lprib/sbc3/docs/hardware/screen_1_dims.webp

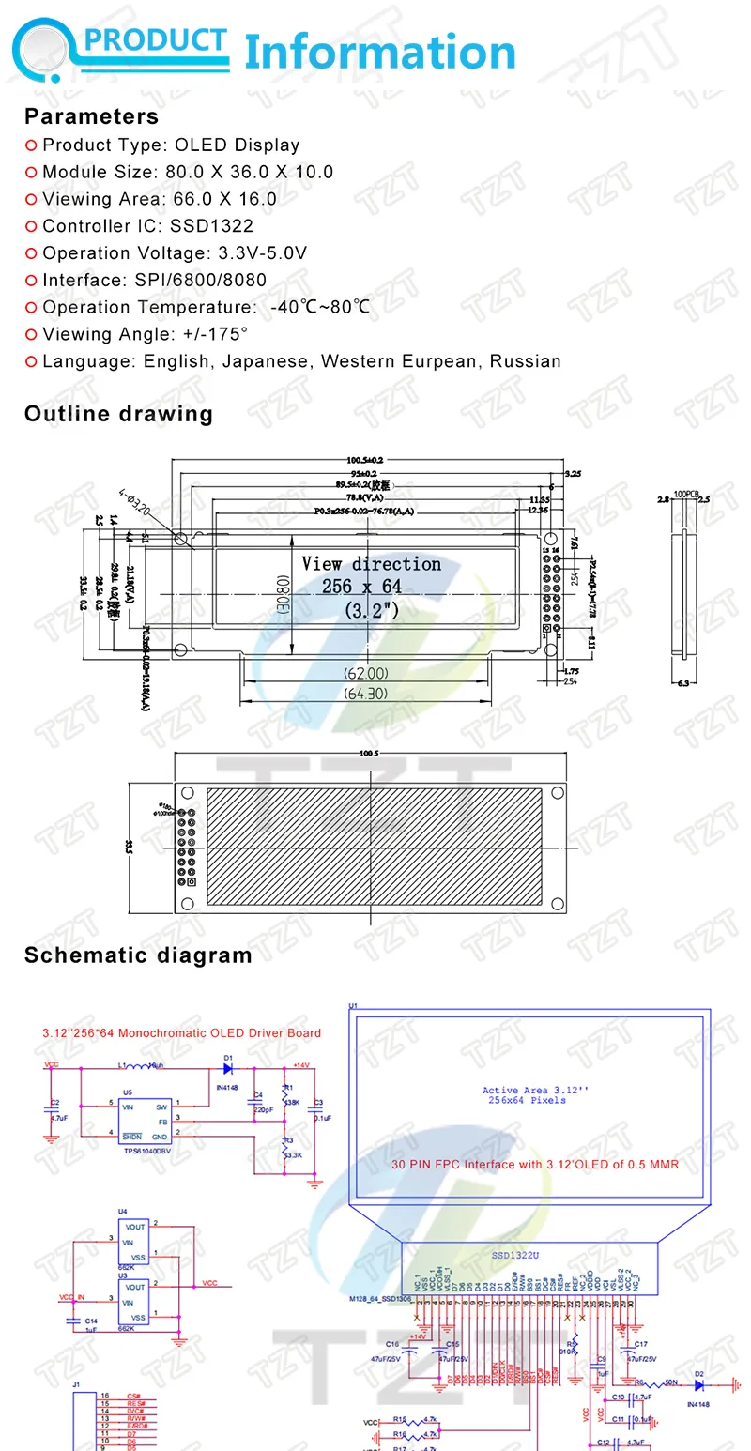
docs/hardware/screen_1_dims.webp
