lprib/sbc3/docs/hardware/ssd1322_oled_module.webp

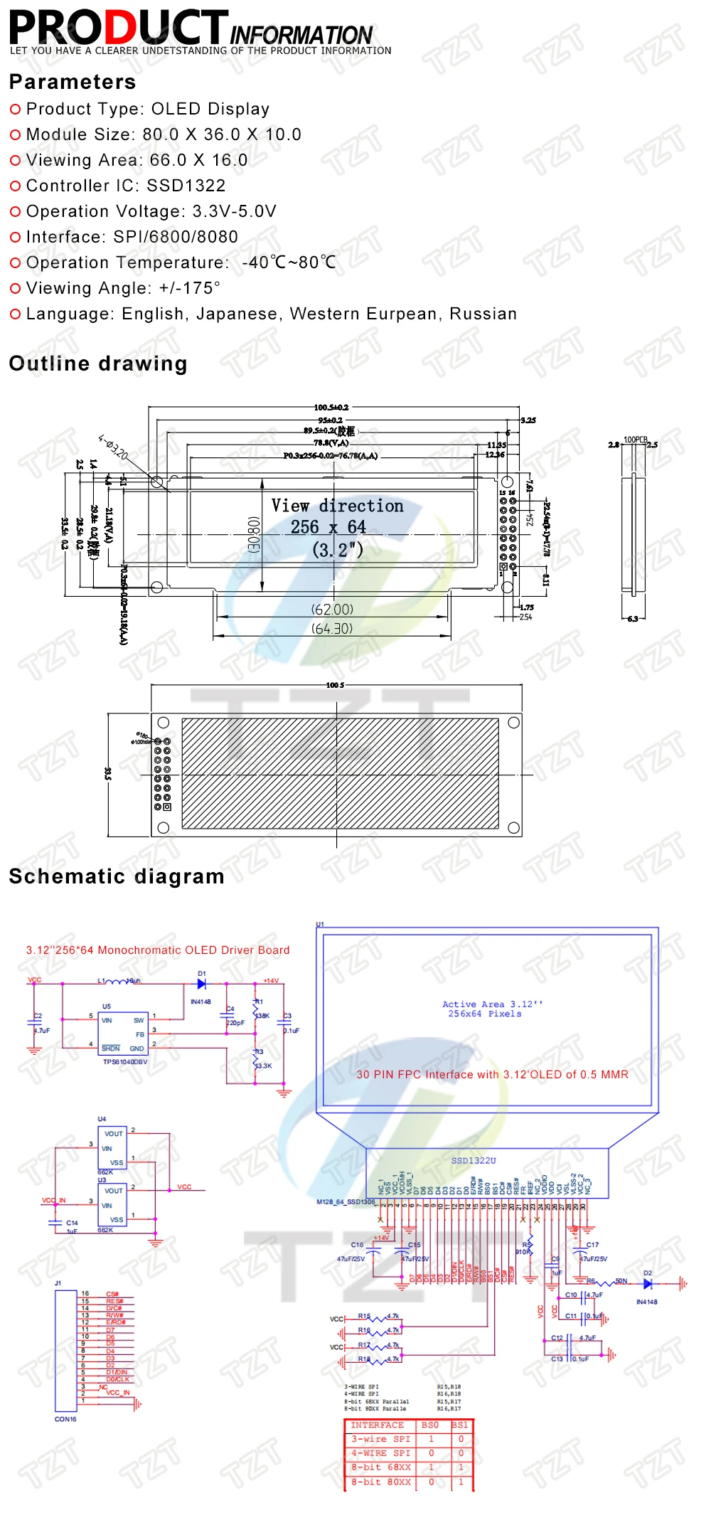
docs/hardware/ssd1322_oled_module.webp
