lprib/sbc3/rust_firmware/libui/src/text/font.png

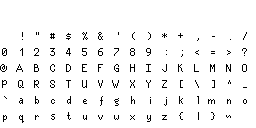
rust_firmware/libui/src/text/font.png
