lprib/sbc3/software/vm/pc_port/font2.png

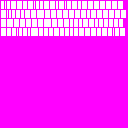
software/vm/pc_port/font2.png
