lprib/sbc3/keyboard_v1/keyboard.kicad_pcb

## KiCad design keyboard_v1/keyboard.kicad_pcb (2023-11-20)

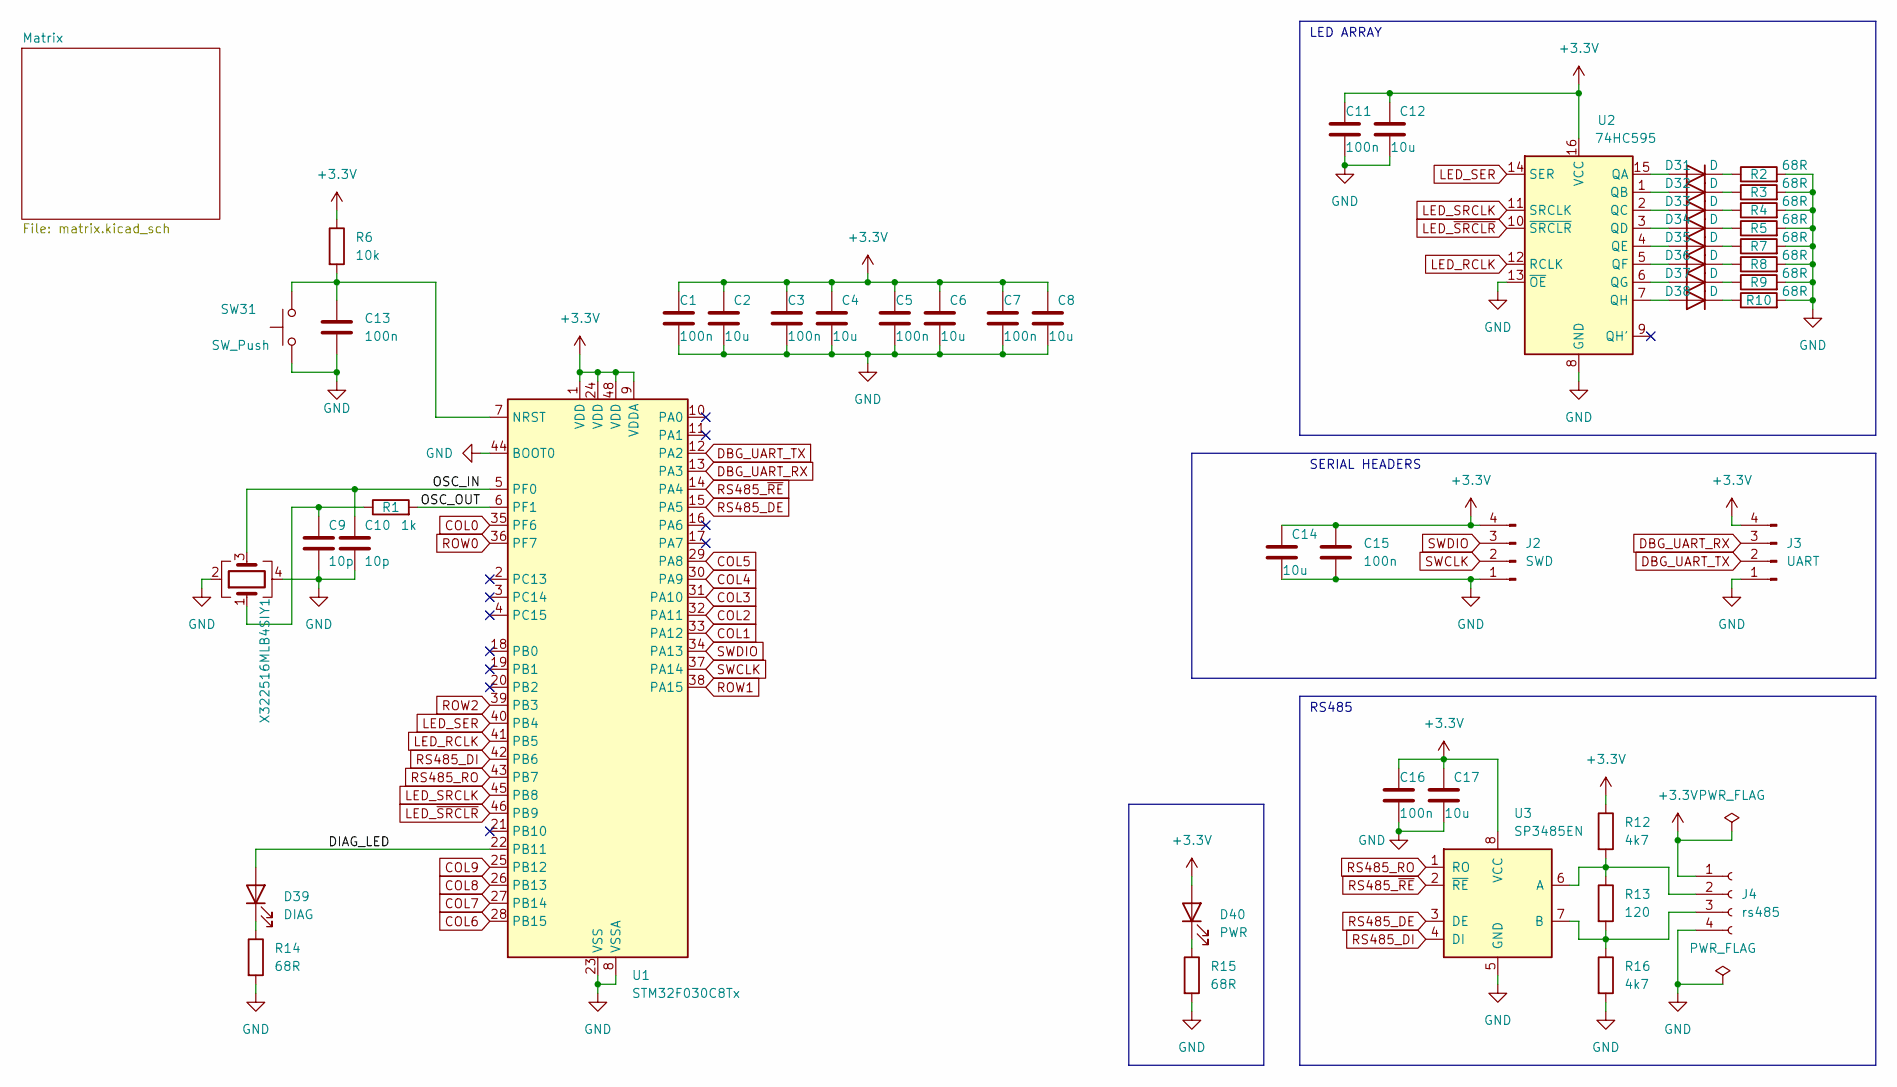
[picture p15: schematic keyboard.kicad_sch]

Parts:
C1, C3, C5, C7, C11, C13, C15, C16: 100n; C_0402_1005Metric; LCSC C307331
C2, C4, C6, C8, C12, C14, C17: 10u; C_0603_1608Metric; LCSC C96446
C9, C10: 10p; C_0402_1005Metric; LCSC C32949
D31, D32, D33, D34, D35, D36, D37, D38: D; D_0603_1608Metric; LCSC C72038
D39: DIAG; D_0603_1608Metric; LCSC C72038
D40: PWR; D_0603_1608Metric; LCSC C72038
J2: SWD; PinHeader_1x04_P2.54mm_Vertical
J3: UART; PinHeader_1x04_P2.54mm_Vertical
J4: rs485; JST_SH_SM04B-SRSS-TB_1x04-1MP_P1.00mm_Horizontal
R1: 1k; R_0402_1005Metric; LCSC C11702
R2, R3, R4, R5, R7, R8, R9, R10, R14, R15: 68R; R_0603_1608Metric; LCSC C27592
R6: 10k; R_0402_1005Metric; LCSC C25744
R12, R16: 4k7; R_1206_3216Metric; LCSC C17936
R13: 120; R_1206_3216Metric; LCSC C17909
SW31: SW_Push; SW_Push_1P1T_XKB_TS-1187A; LCSC C318884
U1: STM32F030C8Tx; LQFP-48_7x7mm_P0.5mm; LCSC C23922
U2: 74HC595; SOIC-16_3.9x9.9mm_P1.27mm; LCSC C5947
U3: SP3485EN; SOIC-8_3.9x4.9mm_P1.27mm
Y1: X322516MLB4SI; Crystal_SMD_SeikoEpson_TSX3225-4Pin_3.2x2.5mm; LCSC C13738

Connections:
+3.3V: C1.1, C2.1, C3.1, C4.1, C5.1, C6.1, C7.1, C8.1, C11.1, C12.1, C14.1, C15.1, C16.1, C17.1, D40.2 (A), J2.4, J3.4, J4.1, R6.1, R12.1, U1.1 (VDD), U1.9 (VDDA), U1.24 (VDD), U1.48 (VDD), U2.16 (VCC), U3.8 (VCC)
/DIAG_LED: D39.2 (A), U1.22 (PB11)
/OSC_IN: C10.1, U1.5 (PF0), Y1.3
/OSC_OUT: R1.2, U1.6 (PF1)
COL0: U1.35 (PF6); also elsewhere on the board
COL1: U1.33 (PA12); also elsewhere on the board
COL2: U1.32 (PA11); also elsewhere on the board
COL3: U1.31 (PA10); also elsewhere on the board
COL4: U1.30 (PA9); also elsewhere on the board
COL5: U1.29 (PA8); also elsewhere on the board
COL6: U1.28 (PB15); also elsewhere on the board
COL7: U1.27 (PB14); also elsewhere on the board
COL8: U1.26 (PB13); also elsewhere on the board
COL9: U1.25 (PB12); also elsewhere on the board
DBG_UART_RX: J3.3, U1.13 (PA3)
DBG_UART_TX: J3.2, U1.12 (PA2)
GND: C1.2, C2.2, C3.2, C4.2, C5.2, C6.2, C7.2, C8.2, C9.2, C10.2, C11.2, C12.2, C13.2, C14.2, C15.2, C16.2, C17.2, J2.1, J3.1, J4.4, R2.2, R3.2, R4.2, R5.2, R7.2, R8.2, R9.2, R10.2, R14.2, R15.2, R16.2, SW31.1, U1.8 (VSSA), U1.23 (VSS), U1.44 (BOOT0), U1.47 (VSS), U2.8 (GND), U2.13 (~OE), U3.5 (GND), Y1.2, Y1.4
LED_RCLK: U1.41 (PB5), U2.12 (RCLK)
LED_SER: U1.40 (PB4), U2.14 (SER)
LED_SRCLK: U1.45 (PB8), U2.11 (SRCLK)
LED_~SRCLR: U1.46 (PB9), U2.10 (~SRCLR)
unnamed: C9.1, R1.1, Y1.1
unnamed: D31.2 (A), U2.15 (QA)
unnamed: D31.1 (K), R2.1
unnamed: D32.2 (A), U2.1 (QB)
unnamed: D32.1 (K), R3.1
unnamed: D33.2 (A), U2.2 (QC)
unnamed: D33.1 (K), R4.1
unnamed: D34.2 (A), U2.3 (QD)
unnamed: D34.1 (K), R5.1
unnamed: D35.2 (A), U2.4 (QE)
unnamed: D35.1 (K), R7.1
unnamed: D36.2 (A), U2.5 (QF)
unnamed: D36.1 (K), R8.1
unnamed: D37.2 (A), U2.6 (QG)
unnamed: D37.1 (K), R9.1
unnamed: D38.2 (A), U2.7 (QH)
unnamed: D38.1 (K), R10.1
unnamed: D39.1 (K), R14.1
unnamed: D40.1 (K), R15.1
unnamed: J4.2, R12.2, R13.1, U3.6 (A)
unnamed: J4.3, R13.2, R16.1, U3.7 (B)
unnamed: C13.1, R6.2, SW31.2, U1.7 (NRST)
ROW0: U1.36 (PF7); also elsewhere on the board
ROW1: U1.38 (PA15); also elsewhere on the board
ROW2: U1.39 (PB3); also elsewhere on the board
RS485_DE: U1.15 (PA5), U3.3 (DE)
RS485_DI: U1.42 (PB6), U3.4 (DI)
RS485_RO: U1.43 (PB7), U3.1 (RO)
RS485_~RE: U1.14 (PA4), U3.2 (~RE)
SWCLK: J2.2, U1.37 (PA14)
SWDIO: J2.3, U1.34 (PA13)

Notes on the sheet:
RS485
SERIAL HEADERS
LED ARRAY

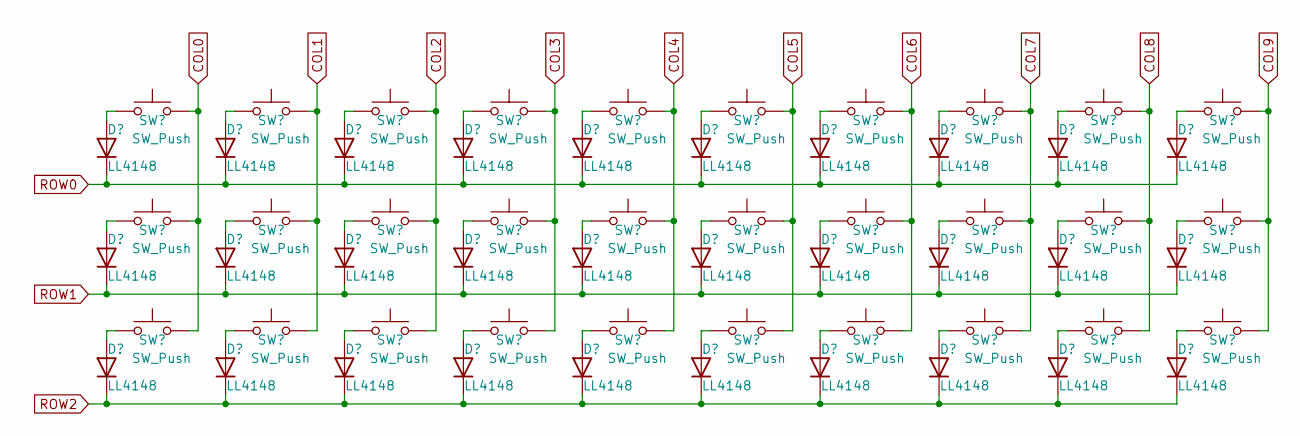
[picture p16: schematic matrix.kicad_sch]

Parts:
D1, D2, D3, D4, D5, D6, D7, D8, D9, D10, D11, D12, D13, D14, D15, D16, D17, D18, D19, D20, D21, D22, D23, D24, D25, D26, D27, D28, D29, D30: LL4148; D_1206_3216Metric; LCSC C9808
SW1, SW2, SW3, SW4, SW5, SW6, SW7, SW8, SW9, SW10, SW11, SW12, SW13, SW14, SW15, SW16, SW17, SW18, SW19, SW20, SW21, SW22, SW23, SW24, SW25, SW26, SW27, SW28, SW29, SW30: SW_Push; SW_Cherry_MX_1.00u_PCB

Connections:
COL0: SW1.2, SW11.2, SW21.2; also elsewhere on the board
COL1: SW2.2, SW12.2, SW22.2; also elsewhere on the board
COL2: SW3.2, SW13.2, SW23.2; also elsewhere on the board
COL3: SW4.2, SW14.2, SW24.2; also elsewhere on the board
COL4: SW5.2, SW15.2, SW25.2; also elsewhere on the board
COL5: SW6.2, SW16.2, SW26.2; also elsewhere on the board
COL6: SW7.2, SW17.2, SW27.2; also elsewhere on the board
COL7: SW8.2, SW18.2, SW28.2; also elsewhere on the board
COL8: SW9.2, SW19.2, SW29.2; also elsewhere on the board
COL9: SW10.2, SW20.2, SW30.2; also elsewhere on the board
unnamed: D1.2 (A), SW1.1
unnamed: D2.2 (A), SW2.1
unnamed: D3.2 (A), SW3.1
unnamed: D4.2 (A), SW4.1
unnamed: D5.2 (A), SW5.1
unnamed: D6.2 (A), SW6.1
unnamed: D7.2 (A), SW7.1
unnamed: D8.2 (A), SW8.1
unnamed: D9.2 (A), SW9.1
unnamed: D10.2 (A), SW10.1
unnamed: D11.2 (A), SW11.1
unnamed: D12.2 (A), SW12.1
unnamed: D13.2 (A), SW13.1
unnamed: D14.2 (A), SW14.1
unnamed: D15.2 (A), SW15.1
unnamed: D16.2 (A), SW16.1
unnamed: D17.2 (A), SW17.1
unnamed: D18.2 (A), SW18.1
unnamed: D19.2 (A), SW19.1
unnamed: D20.2 (A), SW20.1
unnamed: D21.2 (A), SW21.1
unnamed: D22.2 (A), SW22.1
unnamed: D23.2 (A), SW23.1
unnamed: D24.2 (A), SW24.1
unnamed: D25.2 (A), SW25.1
unnamed: D26.2 (A), SW26.1
unnamed: D27.2 (A), SW27.1
unnamed: D28.2 (A), SW28.1
unnamed: D29.2 (A), SW29.1
unnamed: D30.2 (A), SW30.1
ROW0: D1.1 (K), D2.1 (K), D3.1 (K), D4.1 (K), D5.1 (K), D6.1 (K), D7.1 (K), D8.1 (K), D9.1 (K), D10.1 (K); also elsewhere on the board
ROW1: D11.1 (K), D12.1 (K), D13.1 (K), D14.1 (K), D15.1 (K), D16.1 (K), D17.1 (K), D18.1 (K), D19.1 (K), D20.1 (K); also elsewhere on the board
ROW2: D21.1 (K), D22.1 (K), D23.1 (K), D24.1 (K), D25.1 (K), D26.1 (K), D27.1 (K), D28.1 (K), D29.1 (K), D30.1 (K); also elsewhere on the board

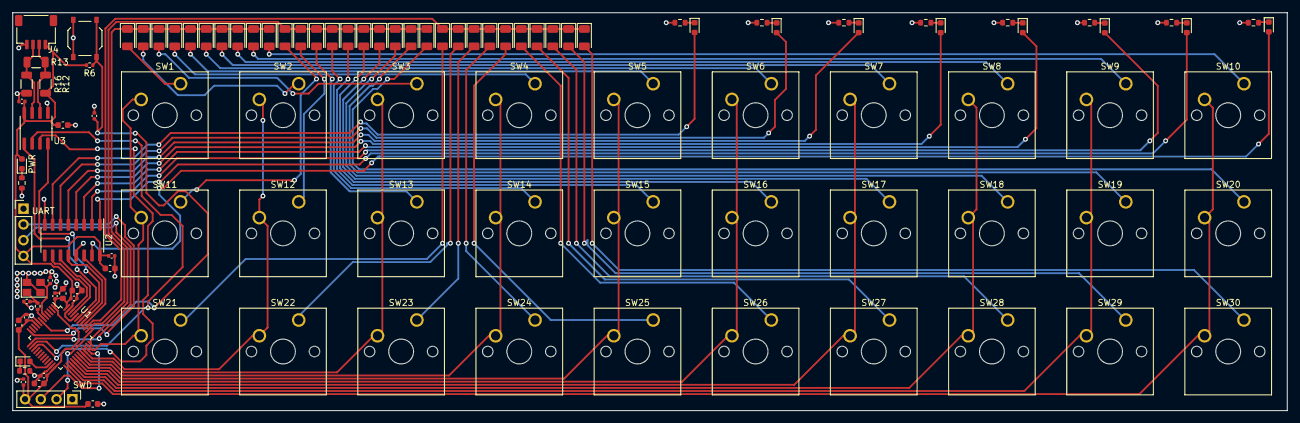
[picture p17: board keyboard.kicad_pcb from above]

Board: 2 copper layers, 205.5 x 64.2 mm, 110 parts (0 on the bottom side), 82 nets.
