lprib/sbc3/main_board_v1/sbc3_pcb.kicad_pcb

## KiCad design main_board_v1/sbc3_pcb.kicad_pcb (2023-11-12)

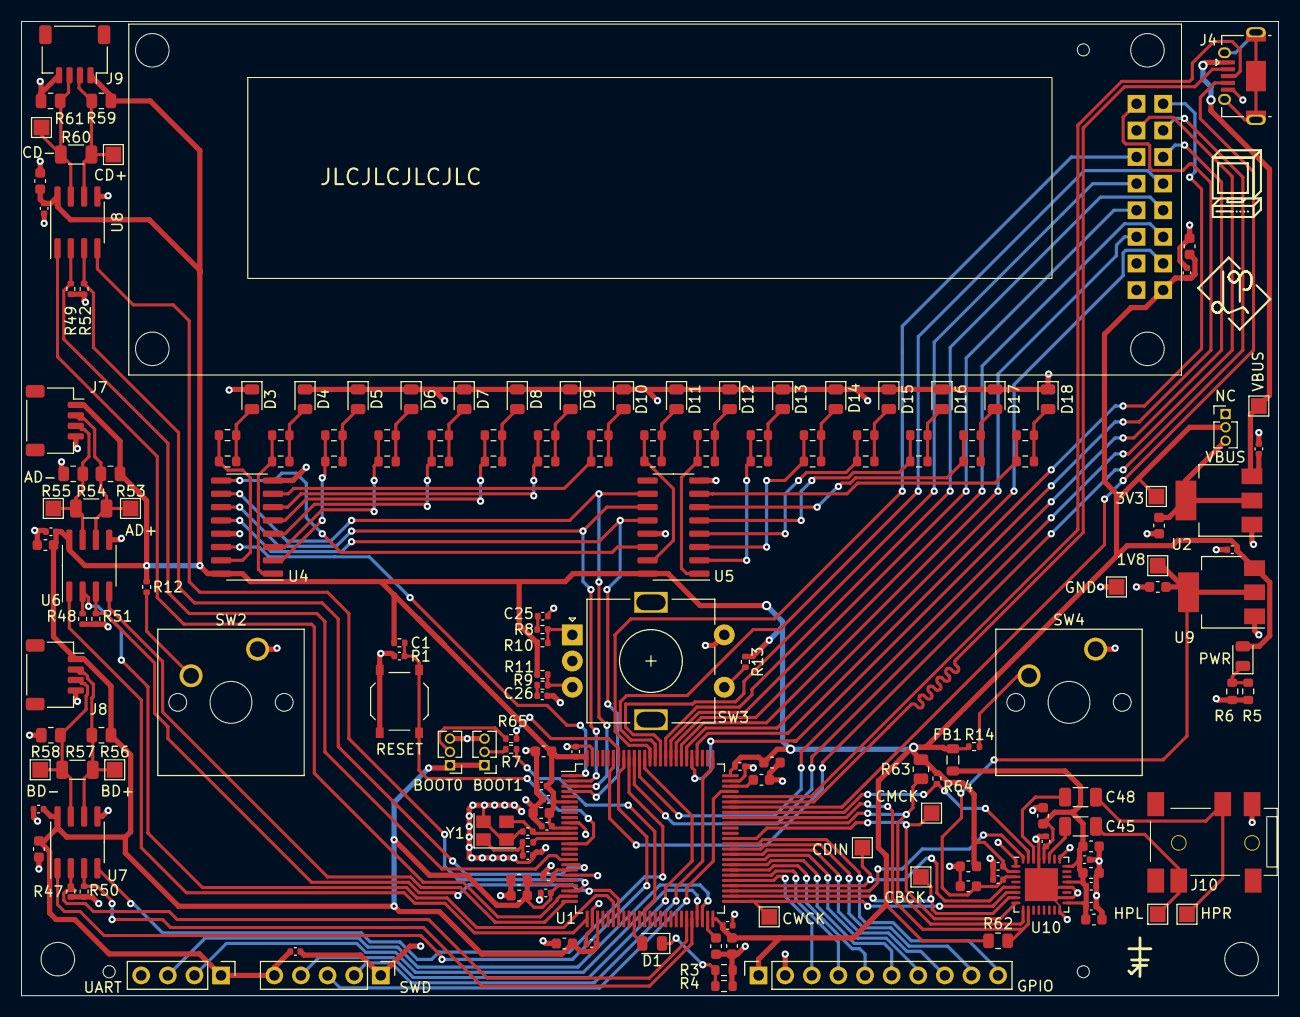
[picture p18: board sbc3_pcb.kicad_pcb from above]

Board: 2 copper layers, 120.0 x 93.0 mm, 181 parts (0 on the bottom side), 122 nets.

Parts:
C1, C6, C9, C11, C12, C14, C17, C18, C20, C22, C24, C28, C29, C31, C33, C35, C40, C42, C44, C47, C50, C52: 100n; C_0402_1005Metric
C2, C3: 10p; C_0402_1005Metric
C4, C5: 2.2u; C_0603_1608Metric
C7: 1u; C_0402_1005Metric
C8, C10, C13, C15, C16, C19, C21, C23, C27, C30, C32, C34, C36, C39, C41, C43, C46, C49, C51: 10u; C_0603_1608Metric
C25, C26: 10n; C_0402_1005Metric
C45, C48: 47u; C_1206_3216Metric
D1: DBG; LED_0805_2012Metric
D2: PWR; LED_0805_2012Metric
D3, D4, D5, D6, D7, D8, D9, D10, D11, D12, D13, D14, D15, D16, D17, D18: LED; LED_0805_2012Metric
FB1: FerriteBead; L_0805_2012Metric
H1, H2: MountingHole; MountingHole_3.2mm_M3
H3, H4, H5: MountingHole; MountingHole_JLCPCB_Assembly
J1: VBUS CON; PinHeader_1x03_P1.27mm_Vertical
J2: BOOT0; PinHeader_1x03_P1.27mm_Vertical
J3: GPIO; PinSocket_1x10_P2.54mm_Vertical
J4: USB_B_Micro; USB_Micro-AB_Molex_47590-0001
J5: UART; PinHeader_1x04_P2.54mm_Vertical
J6: SWD; PinHeader_1x05_P2.54mm_Vertical
J7, J8, J9: Conn_01x04_Socket; JST_SH_SM04B-SRSS-TB_1x04-1MP_P1.00mm_Horizontal
J10: PJ-342
J11: BOOT1; PinHeader_1x03_P1.27mm_Vertical
R1, R7, R8, R9, R10, R11, R12, R13, R14, R47, R48, R49, R50, R51, R52, R64, R65: 10k; R_0402_1005Metric
R2: 1k; R_0402_1005Metric
R3, R4, R5, R6, R15, R16, R17, R18, R19, R20, R21, R22, R23, R24, R25, R26, R27, R28, R29, R30, R31, R32, R33, R34, R35, R36, R37, R38, R39, R40, R41, R42, R43, R44, R45, R46: 150; R_0603_1608Metric
R53, R55, R56, R58, R59, R61, R62, R63: 4k7; R_0805_2012Metric
R54, R57, R60: 120; R_1206_3216Metric
SW1: RESET; SW_Push_1P1T_XKB_TS-1187A
SW2, SW4: CHERRY_SWITCH; SW_Cherry_MX_1.00u_PCB
SW3: RotaryEncoder_Switch; RotaryEncoder_Alps_EC11E-Switch_Vertical_H20mm
TP1: 3V3; MyTP
TP3: VBUS; MyTP
TP4: AD+; MyTP
TP5: AD-; MyTP
TP6: BD+; MyTP
TP7: BD-; MyTP
TP8: CD+; MyTP
TP9: CD-; MyTP
TP10: 1V8; MyTP
TP11: CMCK; MyTP
TP12: CDIN; MyTP
TP13: CBCK; MyTP
TP14: CWCK; MyTP
TP15: HPR; MyTP
TP16: HPL; MyTP
TP17: GND; MyTP
U1: STM32F405VGT6; LQFP-100_14x14mm_P0.5mm
U2: LD1117S33TR_SOT223; SOT-223-3_TabPin2
U3: 256x64 SSD1322 Module; SSD1322_oled_module_3.12inch
U4, U5: 74HC595D,118; SOIC-16_3.9x9.9mm_P1.27mm
U6, U7, U8: SP3485EN-L/TR; SOIC-8_3.9x4.9mm_P1.27mm
U9: LD1117S18TR_SOT223; SOT-223-3_TabPin2
U10: TLV320DAC3101IRHBR; VQFN-32-1EP_5x5mm_P0.5mm_EP3.15x3.15mm
Y1: 16MHz; Crystal_SMD_3225-4Pin_3.2x2.5mm

Connections:
+1V8: C36.1, C51.1, C52.1, TP10.1, U9.2 (VO), U10.3 (DVDD)
+3.3V: C6.1, C7.1, C8.1, C9.1, C10.1, C12.1, C13.1, C14.1, C15.1, C17.1, C18.1, C19.1, C20.1, C21.1, C22.1, C23.1, C24.1, C27.1, C28.1, C29.1, C30.1, C31.1, C32.1, C33.1, C34.1, C35.1, C49.1, C50.1, D2.2 (A), FB1.1, J1.2, J2.1, J3.1, J5.1, J6.5, J7.1, J8.1, J9.1, J11.1, R1.2, R10.2, R11.2, R12.1, R13.1, R14.1, R53.1, R56.1, R59.1, R62.1, R63.1, R64.1, TP1.1, U1.6 (VBAT), U1.11 (VDD), U1.19 (VDD), U1.21 (VREF+), U1.22 (VDDA), U1.28 (VDD), U1.50 (VDD), U1.75 (VDD), U1.100 (VDD), U3.2 (VCC), U4.16 (VCC), U5.16 (VCC), U6.8 (VCC), U7.8 (VCC), U8.8 (VCC), U9.3 (VI), U10.2 (IOVDD)
/Audio/HPL_OUT: C45.1, J10.5 (T), TP16.1
/Audio/HPL_PRE: C45.2, U10.27 (HPL)
/Audio/HPR_OUT: C48.1, J10.4 (R2), TP15.1
/Audio/HPR_PRE: C48.2, U10.30 (HPR)
/Audio/HP_VDD: C39.1, C40.1, C41.1, C42.1, C43.1, C44.1, C46.1, C47.1, FB1.2, U10.17 (AVDD), U10.21 (SPLVDD), U10.24 (SPRVDD), U10.28 (HPVDD)
/BOOT0: R7.2, U1.94 (BOOT0)
/BOOT1: R65.2, U1.37 (PB2)
/CODEC_BCLK: TP13.1, U1.52 (PB13), U10.7 (BCLK)
/CODEC_DIN: TP12.1, U1.54 (PB15), U10.5 (DIN)
/CODEC_GPIO1: U1.53 (PB14), U10.32 (GPIO1)
/CODEC_MCLK: TP11.1, U1.63 (PC6), U10.8 (MCLK)
/CODEC_NRESET: R64.2, U1.68 (PA9), U10.31 (~RESET)
/CODEC_SCL: R62.2, U1.67 (PA8), U10.10 (SCL)
/CODEC_SDA: R63.2, U1.66 (PC9), U10.9 (SDA)
/CODEC_WCLK: TP14.1, U1.51 (PB12), U10.6 (WCLK)
/Comms/RS485_A_D+: J7.2, R53.2, R54.1, TP4.1, U6.6 (A)
/Comms/RS485_A_D-: J7.3, R54.2, R55.1, TP5.1, U6.7 (B)
/Comms/RS485_B_D+: J8.2, R56.2, R57.1, TP6.1, U7.6 (A)
/Comms/RS485_B_D-: J8.3, R57.2, R58.1, TP7.1, U7.7 (B)
/Comms/RS485_C_D+: J9.2, R59.2, R60.1, TP8.1, U8.6 (A)
/Comms/RS485_C_D-: J9.3, R60.2, R61.1, TP9.1, U8.7 (B)
/DBG_LED: D1.2 (A), U1.35 (PB0)
/DBG_UART_RX: J5.3, U1.48 (PB11)
/DBG_UART_TX: J5.2, U1.47 (PB10)
/EXT_A.DE: R51.1, U1.32 (PA7), U6.3 (DE)
/EXT_A.DI: U1.25 (PA2), U6.4 (DI)
/EXT_A.NRE: R48.1, U1.31 (PA6), U6.2 (~RE)
/EXT_A.RO: U1.26 (PA3), U6.1 (RO)
/EXT_B.DE: R50.1, U1.46 (PE15), U7.3 (DE)
/EXT_B.DI: U1.92 (PB6), U7.4 (DI)
/EXT_B.NRE: R47.1, U1.45 (PE14), U7.2 (~RE)
/EXT_B.RO: U1.93 (PB7), U7.1 (RO)
/EXT_C.DE: R52.1, U1.18 (PC3), U8.3 (DE)
/EXT_C.DI: U1.23 (PA0), U8.4 (DI)
/EXT_C.NRE: R49.1, U1.17 (PC2), U8.2 (~RE)
/EXT_C.RO: U1.24 (PA1), U8.1 (RO)
/GPIOA_0: J3.3, U1.55 (PD8)
/GPIOA_1: J3.4, U1.56 (PD9)
/GPIOA_2: J3.5, U1.57 (PD10)
/GPIOA_3: J3.6, U1.58 (PD11)
/GPIOA_4: J3.7, U1.59 (PD12)
/GPIOA_5: J3.8, U1.60 (PD13)
/GPIOA_6: J3.9, U1.61 (PD14)
/GPIOA_7: J3.10, U1.62 (PD15)
/LEDS.RCLK: U1.4 (PE5), U4.12 (RCLK), U5.12 (RCLK)
/LEDS.SER: U1.1 (PE2), U4.14 (SER)
/LEDS.SRCLK: U1.2 (PE3), U4.11 (SRCLK), U5.11 (SRCLK)
/LEDS.SRCLR: U1.3 (PE4), U4.10 (~SRCLR), U5.10 (~SRCLR)
/MMI_ROTARY_A: C26.1, R9.1
/MMI_ROTARY_B: C25.1, R8.1
/MMI_ROTARY_PUSH: R13.2, SW3.S1
/MMI_SW_A: R12.2, SW2.2
/MMI_SW_B: R14.2, SW4.2
/OSC_IN: C3.1, U1.12 (PH0), Y1.3
/OSC_OUT: R2.2, U1.13 (PH1)
/SCR.CS: U1.79 (PC11), U3.16 (~CS)
/SCR.D0: U1.81 (PD0), U3.4 (D0/SCLK)
/SCR.D1: U1.82 (PD1), U3.5 (D1/SDATA)
/SCR.D2: U1.83 (PD2), U3.6 (D2)
/SCR.D3: U1.84 (PD3), U3.7 (D3)
/SCR.D4: U1.85 (PD4), U3.8 (D4)
/SCR.D5: U1.86 (PD5), U3.9 (D5)
/SCR.D6: U1.87 (PD6), U3.10 (D6)
/SCR.D7: U1.88 (PD7), U3.11 (D7)
/SCR.DC: U1.95 (PB8), U3.14 (D~C)
/SCR.E: U1.90 (PB4), U3.12 (E/~RD)
/SCR.RST: U1.80 (PC12), U3.15 (~RST)
/SCR.RW: U1.91 (PB5), U3.13 (R~W)
/SWD_CLK: J6.2, U1.76 (PA14)
/SWD_IO: J6.3, U1.72 (PA13)
/SWD_O: J6.4, U1.89 (PB3)
/USB_D+: J4.3 (D+), U1.71 (PA12)
/USB_D-: J4.2 (D-), U1.70 (PA11)
/USB_ID: J4.4 (ID), U1.69 (PA10)
/USB_VBUS: C11.1, J4.1 (VBUS), TP3.1, U2.3 (VI)
GND: C1.2, C2.2, C3.2, C4.2, C5.2, C6.2, C7.2, C8.2, C9.2, C10.2, C11.2, C12.2, C13.2, C14.2, C15.2, C16.2, C17.2, C18.2, C19.2, C20.2, C21.2, C22.2, C23.2, C24.2, C25.2, C26.2, C27.2, C28.2, C29.2, C30.2, C31.2, C32.2, C33.2, C34.2, C35.2, C36.2, C39.2, C40.2, C41.2, C42.2, C43.2, C44.2, C46.2, C47.2, C49.2, C50.2, C51.2, C52.2, D3.1 (K), D4.1 (K), D5.1 (K), D6.1 (K), D7.1 (K), D8.1 (K), D9.1 (K), D10.1 (K), D11.1 (K), D12.1 (K), D13.1 (K), D14.1 (K), D15.1 (K), D16.1 (K), D17.1 (K), D18.1 (K), J2.3, J3.2, J4.5 (GND), J5.4, J6.1, J7.4, J8.4, J9.4, J10.2 (S), J11.3, R3.2, R4.2, R5.2, R6.2, R47.2, R48.2, R49.2, R50.2, R51.2, R52.2, R55.2, R58.2, R61.2, SW1.1, SW2.1, SW3.C, SW3.S2, SW4.1, TP17.1, U1.10 (VSS), U1.20 (VSSA), U1.27 (VSS), U1.74 (VSS), U1.99 (VSS), U2.1 (GND), U3.1 (VSS), U4.8 (GND), U4.13 (~OE), U5.8 (GND), U5.13 (~OE), U6.5 (GND), U7.5 (GND), U8.5 (GND), U9.1 (GND), U10.1 (IOVSS), U10.16 (AVSS), U10.18 (DVSS), U10.20 (SPLVSS), U10.25 (SPRVSS), U10.29 (HPVSS), U10.33 (PAD), Y1.2, Y1.4
unnamed: C2.1, R2.1, Y1.1
unnamed: D1.1 (K), R3.1, R4.1
unnamed: D2.1 (K), R5.1, R6.1
unnamed: D3.2 (A), R15.2, R16.2
unnamed: D4.2 (A), R17.2, R18.2
unnamed: D5.2 (A), R19.2, R20.2
unnamed: D6.2 (A), R21.2, R22.2
unnamed: D7.2 (A), R23.2, R24.2
unnamed: D8.2 (A), R25.2, R26.2
unnamed: D9.2 (A), R27.2, R28.2
unnamed: D10.2 (A), R29.2, R30.2
unnamed: D11.2 (A), R31.2, R32.2
unnamed: D12.2 (A), R33.2, R34.2
unnamed: D13.2 (A), R35.2, R36.2
unnamed: D14.2 (A), R37.2, R38.2
unnamed: D15.2 (A), R39.2, R40.2
unnamed: D16.2 (A), R41.2, R42.2
unnamed: D17.2 (A), R43.2, R44.2
unnamed: D18.2 (A), R45.2, R46.2
unnamed: C16.1, J1.3, U2.2 (VO)
unnamed: J2.2, R7.1
unnamed: J11.2, R65.1
unnamed: R8.2, R10.1, SW3.A
unnamed: R9.2, R11.1, SW3.B
unnamed: C1.1, R1.1, SW1.2, U1.14 (NRST)
unnamed: C4.1, U1.49 (VCAP_1)
unnamed: C5.1, U1.73 (VCAP_2)
unnamed: R15.1, R16.1, U4.15 (QA)
unnamed: R17.1, R18.1, U4.1 (QB)
unnamed: R19.1, R20.1, U4.2 (QC)
unnamed: R21.1, R22.1, U4.3 (QD)
unnamed: R23.1, R24.1, U4.4 (QE)
unnamed: R25.1, R26.1, U4.5 (QF)
unnamed: R27.1, R28.1, U4.6 (QG)
unnamed: U4.9 (QH'), U5.14 (SER)
unnamed: R29.1, R30.1, U4.7 (QH)
unnamed: R31.1, R32.1, U5.15 (QA)
unnamed: R33.1, R34.1, U5.1 (QB)
unnamed: R35.1, R36.1, U5.2 (QC)
unnamed: R37.1, R38.1, U5.3 (QD)
unnamed: R39.1, R40.1, U5.4 (QE)
unnamed: R41.1, R42.1, U5.5 (QF)
unnamed: R43.1, R44.1, U5.6 (QG)
unnamed: R45.1, R46.1, U5.7 (QH)
