lprib/sbc3/cubemx/main_board_v1/Core/Src/main.c

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
/* Includes ------------------------------------------------------------------*/
#include "main.h"

DAC_HandleTypeDef hdac;

I2C_HandleTypeDef hi2c3;

I2S_HandleTypeDef hi2s2;

UART_HandleTypeDef huart4;
UART_HandleTypeDef huart1;
UART_HandleTypeDef huart2;
UART_HandleTypeDef huart3;

void SystemClock_Config(void);
static void MX_GPIO_Init(void);
static void MX_DAC_Init(void);
static void MX_I2C3_Init(void);
static void MX_I2S2_Init(void);
static void MX_UART4_Init(void);
static void MX_USART1_UART_Init(void);
static void MX_USART2_UART_Init(void);
static void MX_USART3_UART_Init(void);
static void MX_USB_OTG_FS_USB_Init(void);
/* USER CODE BEGIN 0 */

void write_leds(uint16_t val)
{
  HAL_GPIO_WritePin(GPIOE, GPIO_PIN_4, GPIO_PIN_SET);
  HAL_GPIO_WritePin(GPIOE, GPIO_PIN_3, GPIO_PIN_RESET);
  HAL_GPIO_WritePin(GPIOE, GPIO_PIN_5, GPIO_PIN_RESET);

  for(int i = 0; i < 16; i++)
  {
    HAL_GPIO_WritePin(GPIOE, GPIO_PIN_2, val & (0x8000 >> i) ? GPIO_PIN_SET : GPIO_PIN_RESET);
    // HAL_Delay(1);
    HAL_GPIO_WritePin(GPIOE, GPIO_PIN_3, GPIO_PIN_SET);
    // HAL_Delay(1);
    HAL_GPIO_WritePin(GPIOE, GPIO_PIN_3, GPIO_PIN_RESET);
  }
  // HAL_Delay(1);
  HAL_GPIO_WritePin(GPIOE, GPIO_PIN_5, GPIO_PIN_SET);
  // HAL_Delay(1);
  HAL_GPIO_WritePin(GPIOE, GPIO_PIN_5, GPIO_PIN_RESET);
}

/* USER CODE END 0 */

/**
  * @brief  The application entry point.
  * @retval int
  */
int main(void)
{
  /* MCU Configuration--------------------------------------------------------*/

  /* Reset of all peripherals, Initializes the Flash interface and the Systick. */
  HAL_Init();

  /* Configure the system clock */
  SystemClock_Config();

  /* Initialize all configured peripherals */
  MX_GPIO_Init();
  MX_DAC_Init();
  MX_I2C3_Init();
  MX_I2S2_Init();
  MX_UART4_Init();
  MX_USART1_UART_Init();
  MX_USART2_UART_Init();
  MX_USART3_UART_Init();
  MX_USB_OTG_FS_USB_Init();
  /* Infinite loop */
  /* USER CODE BEGIN WHILE */
  unsigned char test[] = "Hello\r\n";

  int i = 0;
  while (1)
  {
    /* USER CODE END WHILE */
    i++;
    if (i >= 16)
    {
      i = 0;
      HAL_UART_Transmit(&huart3, test, sizeof(test), 10);
    }
    write_leds(1<<i);
    // HAL_GPIO_TogglePin(DBG_LED_GPIO_Port, DBG_LED_Pin);
    HAL_Delay(15);
    /* USER CODE BEGIN 3 */
  }
  /* USER CODE END 3 */
}

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
