lprib/sbc3/cubemx/main_board_v1/main_board_v1.ioc

Mcu.UserName=STM32F405VGTx
PA0-WKUP.Signal=UART4_TX
PA1.Signal=UART4_RX
PA10.Signal=USB_OTG_FS_ID
PA11.Signal=USB_OTG_FS_DM
PA12.Signal=USB_OTG_FS_DP
PA13.Signal=SYS_JTMS-SWDIO
PA14.Signal=SYS_JTCK-SWCLK
PA2.Signal=USART2_TX
PA3.Signal=USART2_RX
PA4.Signal=COMP_DAC1_group
PA5.Signal=COMP_DAC2_group
PA6.Signal=GPIO_Output
PA7.Signal=GPIO_Output
PA8.Signal=I2C3_SCL
PA9.GPIO_Label=CODEC_NRESET
PA9.Signal=GPIO_Output
PB0.GPIO_Label=DBG_LED
PB0.Signal=GPIO_Output
PB10.Signal=USART3_TX
PB11.Signal=USART3_RX
PB12.Signal=I2S2_WS
PB13.Signal=I2S2_CK
PB14.GPIO_Label=CODEC_GPIO1
PB14.Signal=GPIO_Input
PB15.Signal=I2S2_SD
PB2.GPIO_Label=BOOT1
PB2.Signal=GPIO_Input
PB3.Signal=SYS_JTDO-SWO
PB4.Signal=GPIO_Output
PB5.Signal=GPIO_Output
PB6.Signal=USART1_TX
PB7.Signal=USART1_RX
PB8.Signal=GPIO_Output
PC11.Signal=GPIO_Output
PC12.Signal=GPIO_Output
PC2.Signal=GPIO_Output
PC3.Signal=GPIO_Output
PC6.Signal=I2S2_MCK
PC9.Signal=I2C3_SDA
PD0.Signal=GPIO_Output
PD1.Signal=GPIO_Output
PD2.Signal=GPIO_Output
PD3.Signal=GPIO_Output
PD4.Signal=GPIO_Output
PD5.Signal=GPIO_Output
PD6.Signal=GPIO_Output
PD7.Signal=GPIO_Output
PE14.Signal=GPIO_Output
PE15.Signal=GPIO_Analog
PE2.Signal=GPIO_Output
PE3.Signal=GPIO_Output
PE4.Signal=GPIO_Output
PE5.Signal=GPIO_Output
PH0-OSC_IN.Signal=RCC_OSC_IN
PH1-OSC_OUT.Signal=RCC_OSC_OUT
