lprib/sbc3/cubemx/main_board_v1/Core/Inc/main.h

#define DBG_LED_Pin GPIO_PIN_0
#define DBG_LED_GPIO_Port GPIOB
#define BOOT1_Pin GPIO_PIN_2
#define BOOT1_GPIO_Port GPIOB
#define CODEC_GPIO1_Pin GPIO_PIN_14
#define CODEC_GPIO1_GPIO_Port GPIOB
#define CODEC_NRESET_Pin GPIO_PIN_9
#define CODEC_NRESET_GPIO_Port GPIOA
