lprib/sbc3/vm/pc_port/GraphicsModule.cpp

#include "GraphicsModule.hpp"
#include "raylib.h"

#include <algorithm>
#include <array>
#include <iostream>

enum Fn {
   SET_DISPLAY_BUF = 0,
   IS_KEY_DOWN = 1,
   BLIT = 2,
   IS_KEY_PRESSED = 3,
   CLEAR_SCREEN = 4,
};

void GraphicsModule::invoke_index(vm::Machine& machine, int fn_id) {
   switch(fn_id) {
   case SET_DISPLAY_BUF:
      // ( buffptr -- )
      m_display_buff_bytecode_address = machine.stack().pop();
      break;
   case IS_KEY_DOWN: {
      // ( key -- down? )
      auto key = machine.stack().pop();
      machine.stack().push(
         IsKeyDown(key) ? vm::Machine::TRUE_WORD : vm::Machine::FALSE_WORD
      );
   } break;
   case IS_KEY_PRESSED: {
      // ( key -- down? )
      auto key = machine.stack().pop();
      machine.stack().push(
         IsKeyPressed(key) ? vm::Machine::TRUE_WORD : vm::Machine::FALSE_WORD
      );
   } break;
   case BLIT: {
      // (x y spriteptr -- )
      auto code = machine.current_module().code();

      auto spriteptr = machine.stack().pop();
      auto y = machine.stack().pop();
      auto x = machine.stack().pop();
      auto sprite_width = code[spriteptr];
      auto sprite_height = code[spriteptr + 1];
      auto sprite = code.subspan(spriteptr + 2, sprite_width * sprite_height);

      // std::cout << "blit x:" << x << " y:" << y << " ptr:" << spriteptr << "
      // w:"
      //           << sprite_width << " h:" << sprite_height << "\n";

      for(int y_iter = 0; y_iter < sprite_height; ++y_iter) {
         auto dest_y = y + y_iter;
         auto src_row = sprite.subspan(y_iter * sprite_width, sprite_width);
         auto dest_row = code.subspan(
            m_display_buff_bytecode_address + dest_y * SCREEN_WIDTH + x,
            sprite_width
         );
         std::copy(src_row.begin(), src_row.end(), dest_row.begin());
      }
   } break;
   case CLEAR_SCREEN: {
      // TODO this should probably be in system module and a generic memset
      auto display = machine.current_module().code().subspan(
         m_display_buff_bytecode_address,
         SCREEN_WIDTH * SCREEN_HEIGHT
      );
      std::fill(display.begin(), display.end(), 0);
   } break;
   default:
      std::cout << "unknown graphics call " << fn_id << "\n";
   }
}

static constexpr std::array<Color, 16> colormap = {
   Color{0, 0, 0, 0xff},
   Color{17, 14, 0, 0xff},
   Color{34, 28, 0, 0xff},
   Color{51, 43, 0, 0xff},
   Color{68, 57, 0, 0xff},
   Color{85, 71, 0, 0xff},
   Color{102, 86, 0, 0xff},
   Color{119, 100, 0, 0xff},
   Color{136, 114, 0, 0xff},
   Color{153, 129, 0, 0xff},
   Color{170, 143, 0, 0xff},
   Color{187, 157, 0, 0xff},
   Color{204, 172, 0, 0xff},
   Color{221, 186, 0, 0xff},
   Color{238, 200, 0, 0xff},
   Color{255, 215, 0, 0xff},
};

void GraphicsModule::draw(vm::Machine& machine) {
   auto progmem = machine.current_module().code();
   for(int y = 0; y < SCREEN_HEIGHT; ++y) {
      for(int x = 0; x < SCREEN_WIDTH; ++x) {
         auto pix =
            progmem[m_display_buff_bytecode_address + (y * SCREEN_WIDTH + x)];
         DrawRectangle(
            x * PX_PADDED_SIZE,
            y * PX_PADDED_SIZE,
            PX_SIZE,
            PX_SIZE,
            colormap[pix]
         );
      }
   }
}
