lprib/sbc3/software/vm/engine/engine_common.cpp

#include "engine_common.hpp"

namespace vm {

char const* error_to_str(Error error) {
   switch(error) {
   case Error::InvalidHeader:
      return "Invalid header";
   case Error::ModuleNotFound:
      return "Module not found";
   case Error::EntryNotFound:
      return "`entry` export not found";
   case Error::EofWithoutReturn:
      return "reached end of module without return opcode";
   case Error::ExternCallInvalidFunctionId:
      return "attempt to externally call a function id out of bounds for the "
             "given module";
   default:
      return "<Unknown error>";
   }
}

} // namespace vm
