lprib/sbc3/software/firmware/app/gpio.cpp

#include "gpio.hpp"

#include "stm32f4xx_hal.h"

namespace gpio {
void init() {
   __HAL_RCC_GPIOB_CLK_ENABLE();
   __HAL_RCC_GPIOC_CLK_ENABLE();
   __HAL_RCC_GPIOD_CLK_ENABLE();
   __HAL_RCC_GPIOE_CLK_ENABLE();
}
} // namespace gpio
