lprib/sbc3/software/firmware/app/comms.hpp

#pragma once

#include "gpio.hpp"

namespace comms {

struct network_interface {
   gpio::pin_t nre;
   gpio::pin_t de;
   gpio::pin_t uart_tx;
   gpio::pin_t uart_rx;
};

// void init();

// network_interface a;

} // namespace comms
