lprib/sbc3/software/firmware/app/irq_declarations.hpp

#pragma once

extern "C" {
void USART1_IRQHandler(void);
void USART2_IRQHandler(void);
void USART3_IRQHandler(void);
void UART4_IRQHandler(void);
void UART5_IRQHandler(void);
void USART6_IRQHandler(void);
}
