lprib/sbc3/(commit log)

2023-11-17 Keyboard schematic, file restructure
    [audio.kicad_sch, comms.kicad_sch, keyboard.kicad_pcb, keyboard.kicad_sch, matrix.kicad_sch, mmi.kicad_sch, sbc3_pcb.kicad_pcb, sbc3_pcb.kicad_sch]
2023-11-18 Initial runup with STM32CubeMX
2023-11-18 remove boot selector on keyboard
    [keyboard.kicad_pcb, keyboard.kicad_sch]
2023-11-19 move main schematic
2023-11-20 C UART test
2023-11-20 integrate ledstrip library, uart
2023-11-20 keyboard PCB updates
    [keyboard.kicad_pcb]
2023-11-23 broke screen again, println!
    [main.rs, mod.rs, parallel8080.rs, print.rs]
2023-11-23 Fix some small bugs in screen driver
    [main.rs, mod.rs]
2024-01-22 cosmetic change
    [audio.kicad_sch]
2024-01-24 add warnings and fix them
    [main.cpp, system_clock_config.cpp]
2024-01-25 jank ass ledstrip
2024-02-04 new delay us, leds ting
2024-02-04 add uart that doesnt work :^)
2024-02-04 Fix uart (forgot alternate function :^))
    [gpio.hpp, main.cpp, uart.cpp]
2024-02-05 hardcode uarts
2024-02-05 Low-level uart transmit driver, after much pain
2024-02-06 better error, mutex with lock guard
    [main.cpp, serial.cpp, serial.hpp, sync.hpp, system_clock_config.cpp, uart.cpp]
2024-02-07 better uart abstraction
2024-03-12 impl assembler for module structure
2024-03-22 Implement more framework and some basic opcodes
2024-03-28 tilemap and fix assembler error bug
2024-04-04 fix trace
2024-04-08 bodged buttons and got them working
2024-04-09 first crack at screen driver (borked)
2024-04-11 Screen works! timing tightened
2024-04-13 Profile perf on stm32 and windows
2024-04-14 remove old assembler, it's too far behind
2024-04-17 assembler error ergonomics: duplicate labels
2024-04-21 de-enterprice: Shim -> Common
